TechniStub/Boite-a-histoire/tuto2.png

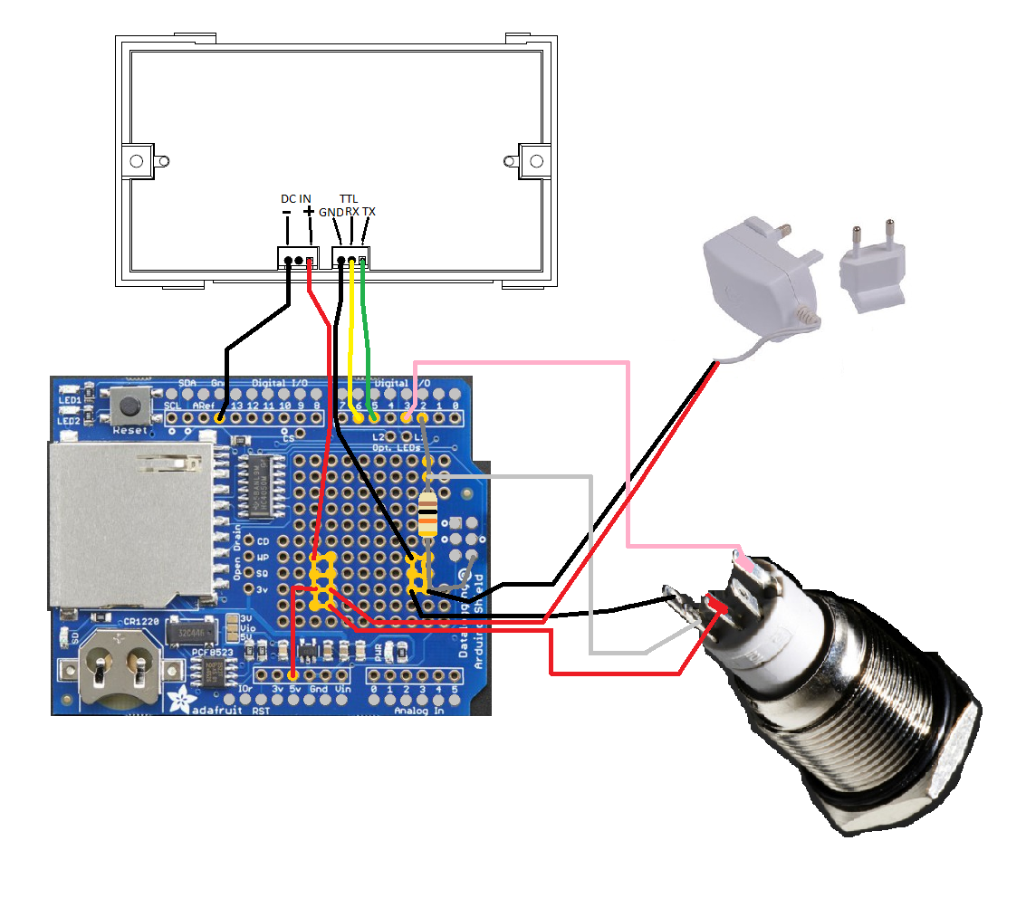
tuto2.png
