TechniStub/Boite-a-histoire/tuto3.png

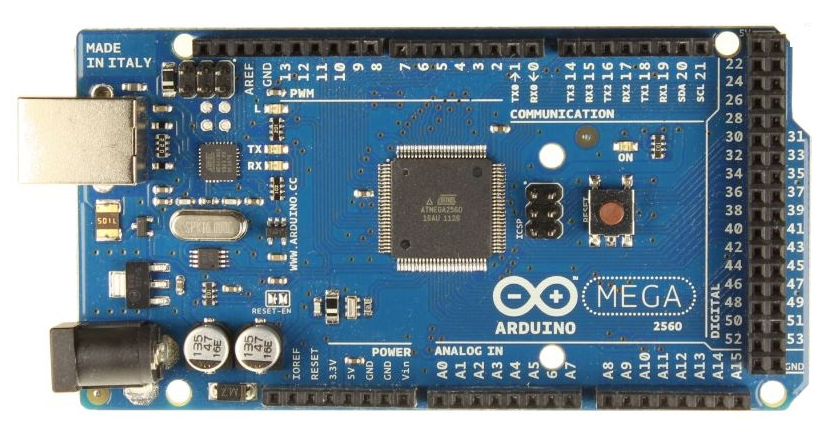
tuto3.png
