TechniStub/Boite-a-histoire/tuto4.png

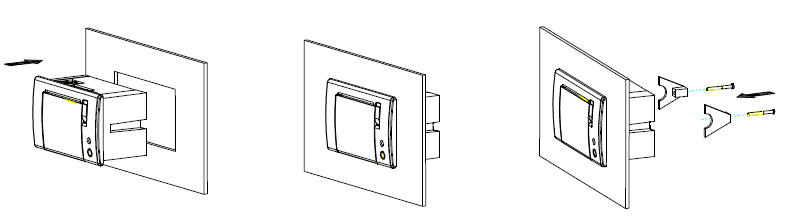
tuto4.png
